xacas/HsqOverNand/hw/art-work.png

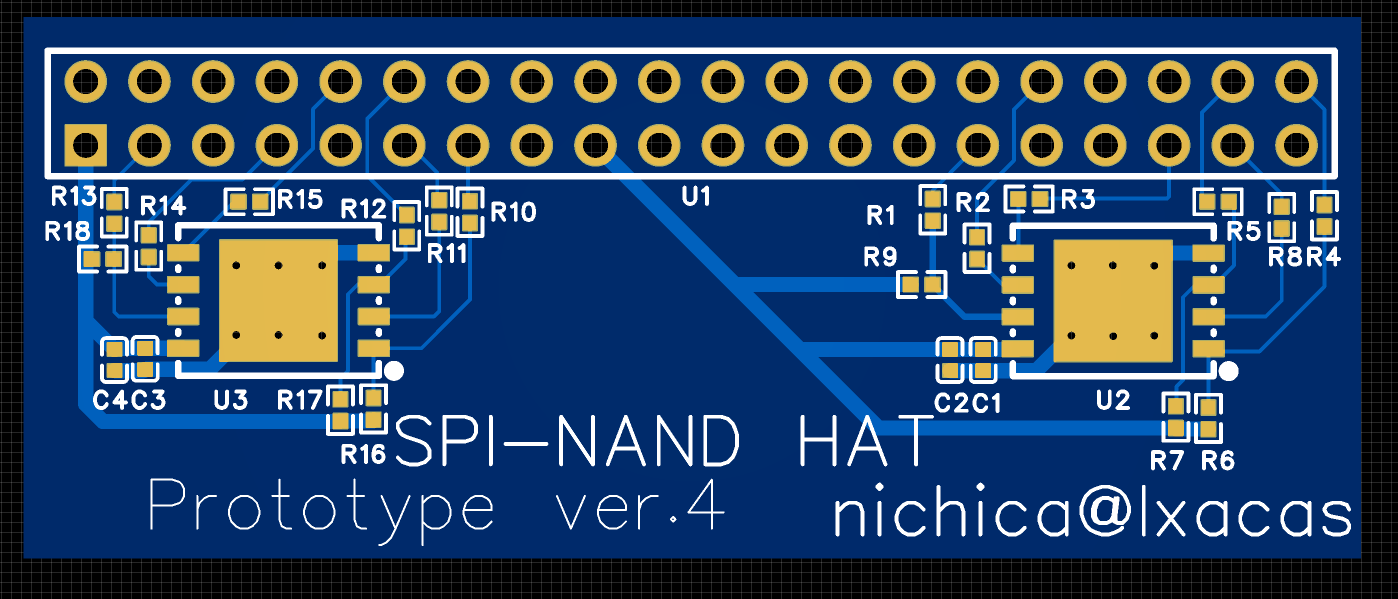
hw/art-work.png
