xacas/HsqOverNand/hw/階層型キャリー先見24bit加算器.png

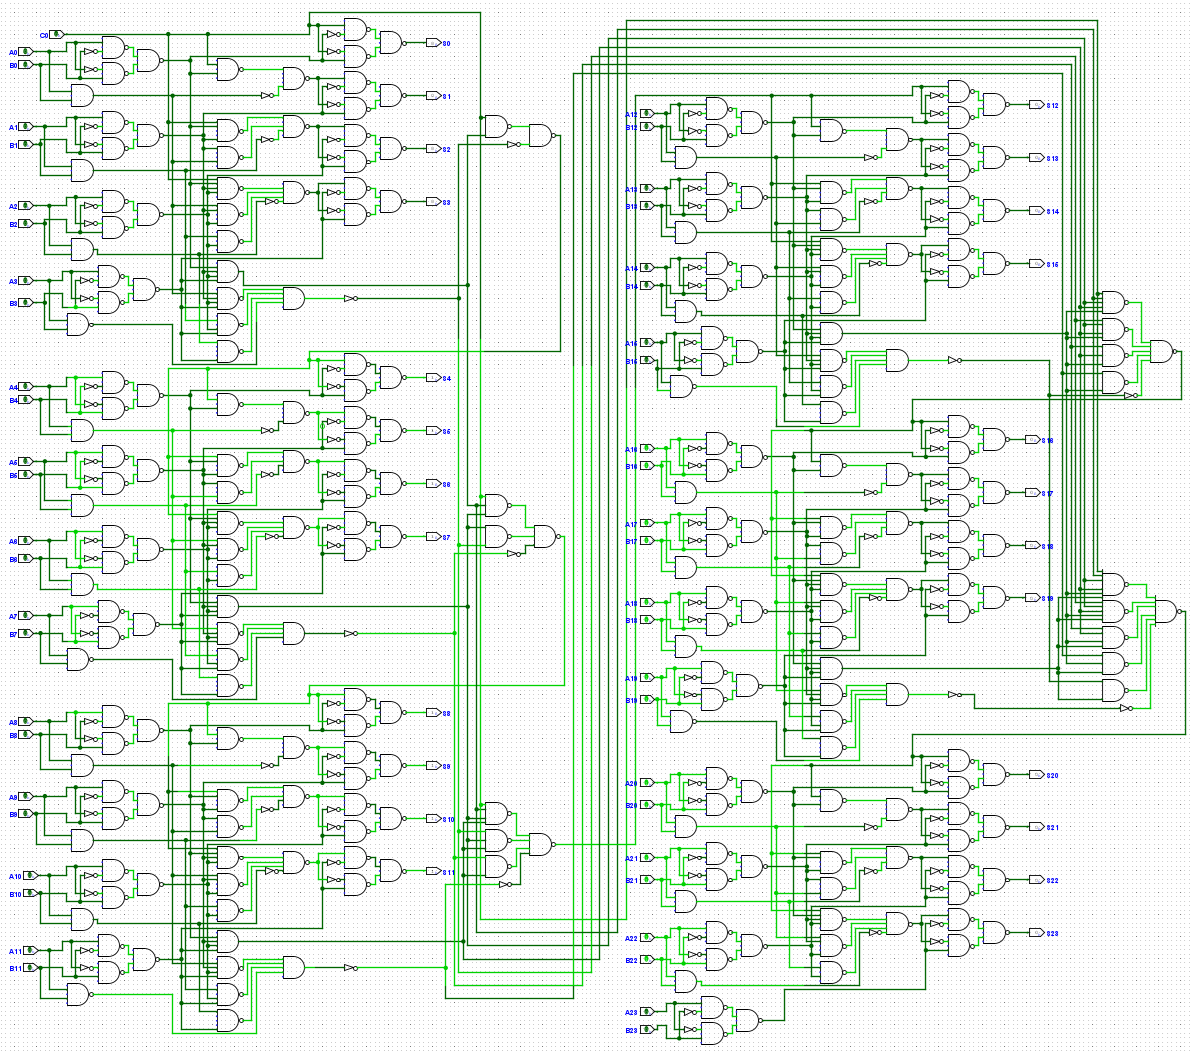
hw/階層型キャリー先見24bit加算器.png
