xacas/HsqOverNand/(list of files, drawings)

Other design files:
hw/carry_look_ahead_only_nand.circ
