xacas/HsqOverNand/(commit log)

2026-07-12 初回コミット: NANDフラッシュを論理素子に使う64bit SUBLEQ計算機
    - NANDのプログラム動作(1→0)をANDゲートとして利用し減算b-aを実行
    - 階層型キャリー先見のネットリスト自動生成・自動ステップスケジューリング
    - 2レーン並列(1ページに2回路、プログラムシーケンス共有)
    - 全容量を使い切ってから一括消去するウェアレベリング
    - Higher Subleqコンパイラ(Oleg Mazonka)の64bit拡張版を同梱
    Claude-Session: https://claude.ai/code/session_01TMmFyGMytvDh6Cx72Jmyc5
    [carry_look_ahead_only_nand.circ]
2026-07-12 ライセンス整備: MIT + hsqはパッチ配布方式に変更
    hsq.cpp(Oleg Mazonka氏作)はライセンス未公表のため再配布せず、
    64bit化パッチ(hsq64.patch)のみをMITで公開する。make hsqが
    オリジナルを公開アーカイブから取得しSHA256検証後にパッチを適用する。
    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
2026-07-12 マルチフラッシュ並列対応: /dev/mtd0..3を自動検出し1デバイス1CPUで並列化
    - nandsimをparts=512,512,512で4分割し/dev/mtd0..3(各64MB)を作成(run.sh)
    - nandInterface/CPUをデバイスパス指定可能に(1デバイス=1CPU=2レーン)
    - CPU毎のワーカースレッドが同一UDPソケットを共有(クライアント無変更)
    - edit_bufのページ切替検出をstatic変数からCPUメンバへ(複数CPUでの競合を修正)
    - 相乗り待ちは共有ClientTrackerで「アクティブクライアント数>CPU数」のときだけ
    - test/test_multi.cpp: 4CPUのラウンドロビン+4スレッド並列で16,000テスト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
    [cpu.cpp, cpu.hpp, nandInterface.hpp, server.cpp]
2026-07-12 SPI-NAND HAT ver.4対応: RP1 PIOでW25N02KV×2を直接制御 (x1+x4 QSPI)
    RPi5のRP1 PIOでSPI-NAND HAT ver.4 (U2/U3=W25N02KV、独立バス)を
    カーネルドライバなしで叩くドライバとテスト群を追加。
    - x1 SPI: 全二重fdx(コマンド/ステータス) + wrapフリーラン受信バルク
    - x4書き込み: Quad Data Load(32h)。IO0..3が飛び飛びGPIOのため
    out pins,22のワイドOUT+ホスト側ニブルスウィズルで4bit/クロック。
    TX DMA(DREQ閾値0)既定で820ページ/秒(1640KB/s)@div=10
    - x4読み出し: Fast Read Quad Output(6Bh)。in pins,32+ホスト側抽出
    (FIFO 1ワード=4bitのため検証・将来RX DMA用)
    - U2=SM1>U3=SM0固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
2026-07-12 SPI-NAND HAT ver.4の基板アートワークを参考資料として追加
    U2/U3 (W25N02KV) の配置とシルクが確認できるプロトタイプver.4のPCB画像。
    src/qspi/w25n_pio.h のピン割当の出典となる基板。
    Claude-Session: https://claude.ai/code/session_01NySb4UvKo4JEGrcd1YDoVo
2026-07-13 SUBLEQ計算機とSPI-NAND HATを統合: 実チップ2個で動作、sudo/nandsim不要
    nandServerがSPI-NAND HAT ver.4 (W25N02KV×2、RP1 PIO直接制御)を
    フラッシュデバイスとして直接使えるようにした。
    - W25NFlashDevice.hpp: MTD相当のバイトオフセットAPIラッパー。
    チップ間ロック = x4送信(データロード相)のみ排他、x1操作
    (読出/消去/Program Execute/BUSY待ち)は共有で2チップ並行
    - nandInterface: "hat:u2"/"hat:u3"でHATバックエンドに分岐。
    HAT時はLED無効(LEDピンGPIO2/4がU3のio3/clkと衝突するため)
    - nandServer: HAT優先の自動検出(JEDECプローブ)、無ければ従来の
    /dev/mtd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
2026-08-13 HW SPI(spidev)バックエンドをnandServerに統合: 実チップ2個でE2E動作確認
    RP1 PIOによる自前QSPIビットバング(src/qspi/)はHW単体SPIより実測で
    遅かったため、新規チップはLinux spidev経由でRP1のHWSPIペリフェラルを
    直接叩くsrc/spi/(w25n_spidev.c/h)に移行。
    - include/W25NSpiFlashDevice.hpp: 複数チップをラウンドロビンで束ねる
    MTD相当のバイトオフセットAPIラッパー。Program実行(10h)をissue/wait
    に分割した非同期パイプラインが核心(1チップ内はSUBLEQの依存書き込み
    のためパイプライン化不可、複数ページにまたがる書き込みでのみ有効)
    - nandIn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
2026-08-15 UDP 通信の Rtry 処理を追加。
2026-08-15 UDP 通信Client の OpenMP対応を追加。
